maykello/Emulacja-Sony-Unilink/hardware/Sony_Unilink_Emulator.pdf

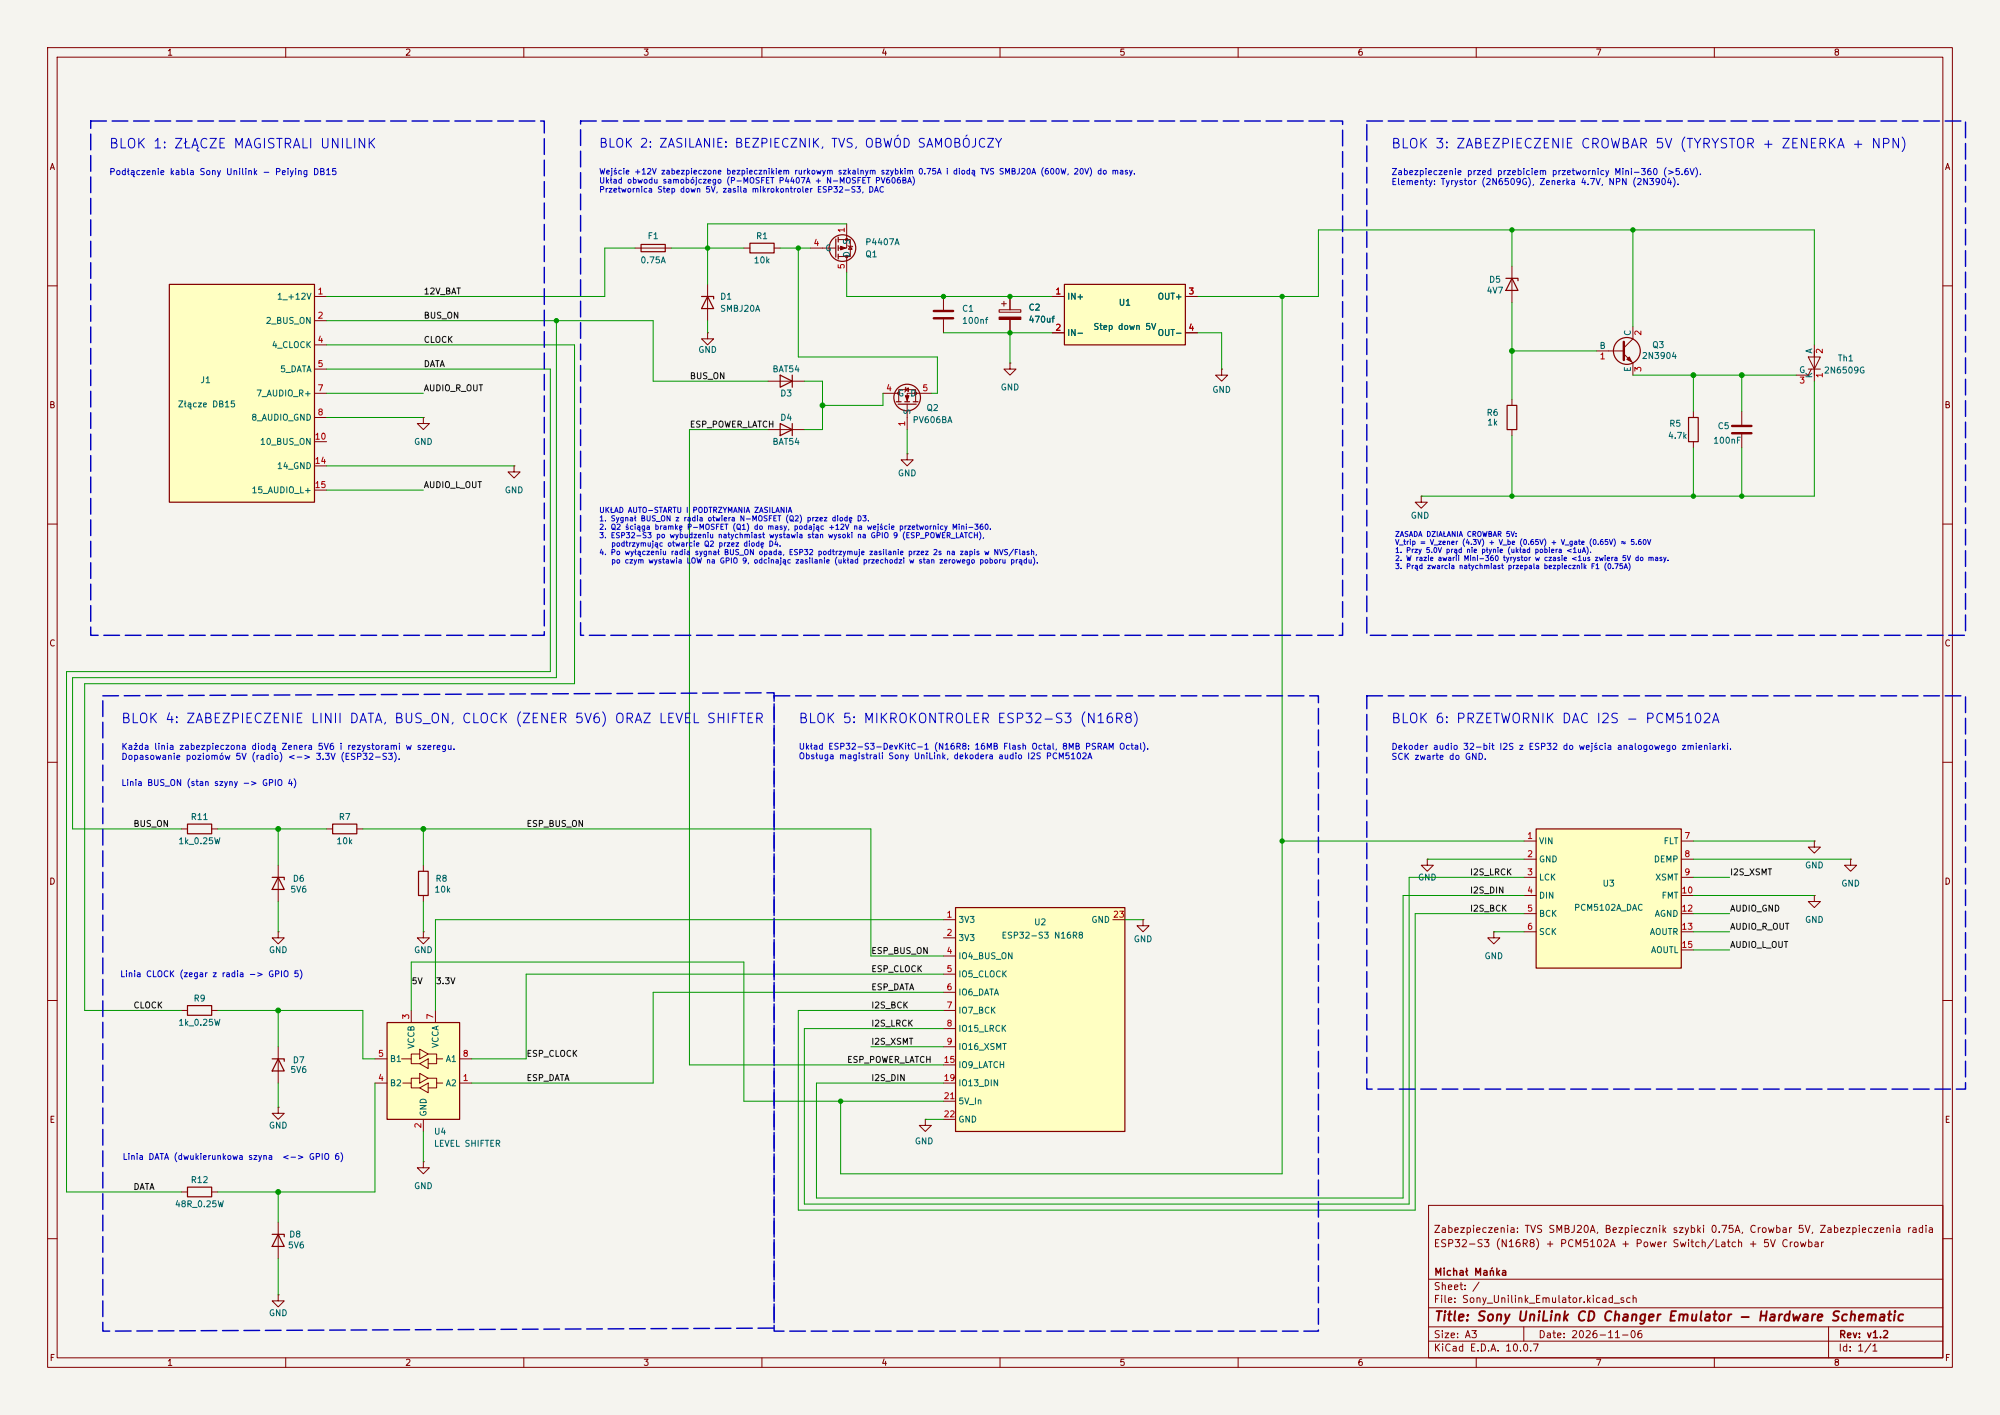
[picture p6: page 1]

Obsługa magistrali Sony UniLink, dekodera audio I2S PCM5102A BLOK 1: ZŁĄCZE MAGISTRALI UNILINK

BLOK 2: ZASILANIE: BEZPIECZNIK, TVS, OBWÓD SAMOBÓJCZY

BLOK 3: ZABEZPIECZENIE CROWBAR 5V (TYRYSTOR + ZENERKA + NPN)

Podłączenie kabla Sony Unilink - Peiying DB15

Wejście +12V zabezpieczone bezpiecznikiem rurkowym szkalnym szybkim 0.75A i diodą TVS SMBJ20A (600W, 20V) do masy. Układ obwodu samobójczego (P-MOSFET P4407A + N-MOSFET PV606BA) Przetwornica Step down 5V, zasila mikrokontroler ESP32-S3, DAC

Zabezpieczenie przed przebiciem przetwornicy Mini-360 (>5.6V).
Elementy: Tyrystor (2N6509G), Zenerka 4.7V, NPN (2N3904).

ZASADA DZIAŁANIA CROWBAR 5V: V_trip = V_zener (4.3V) + V_be (0.65V) + V_gate (0.65V) ≈ 5.60V 1. Przy 5.0V prąd nie płynie (układ pobiera <1uA). 2. W razie awarii Mini-360 tyrystor w czasie <1us zwiera 5V do masy. 3. Prąd zwarcia natychmiast przepala bezpiecznik F1 (0.75A)

BLOK 4: ZABEZPIECZENIE LINII DATA, BUS_ON, CLOCK (ZENER 5V6) ORAZ LEVEL SHIFTER
10k GND

Układ ESP32-S3-DevKitC-1 (N16R8: 16MB Flash Octal, 8MB PSRAM Octal).

Linia BUS_ON (stan szyny -> GPIO 4)

Linia CLOCK (zegar z radia -> GPIO 5)

Linia DATA (dwukierunkowa szyna <-> GPIO 6)

Zabezpieczenia: TVS SMBJ20A, Bezpiecznik szybki 0.75A, Crowbar 5V, Zabezpieczenia radia
ESP32-S3 (N16R8) + PCM5102A + Power Switch/Latch + 5V Crowbar

Michał Mańka
Sheet: /
File: Sony_Unilink_Emulator.kicad_sch
Title: Sony UniLink CD Changer Emulator - Hardware Schematic

Size: A3 | Rev: v1.2 | F Date: 2026-11-06
KiCad E.D.A. 10.0.7 | Id: 1/1
