maykello/Emulacja-Sony-Unilink/hardware/Sony_Unilink_Emulator.kicad_sch

## KiCad design hardware/Sony_Unilink_Emulator.kicad_sch (2026-11-06)

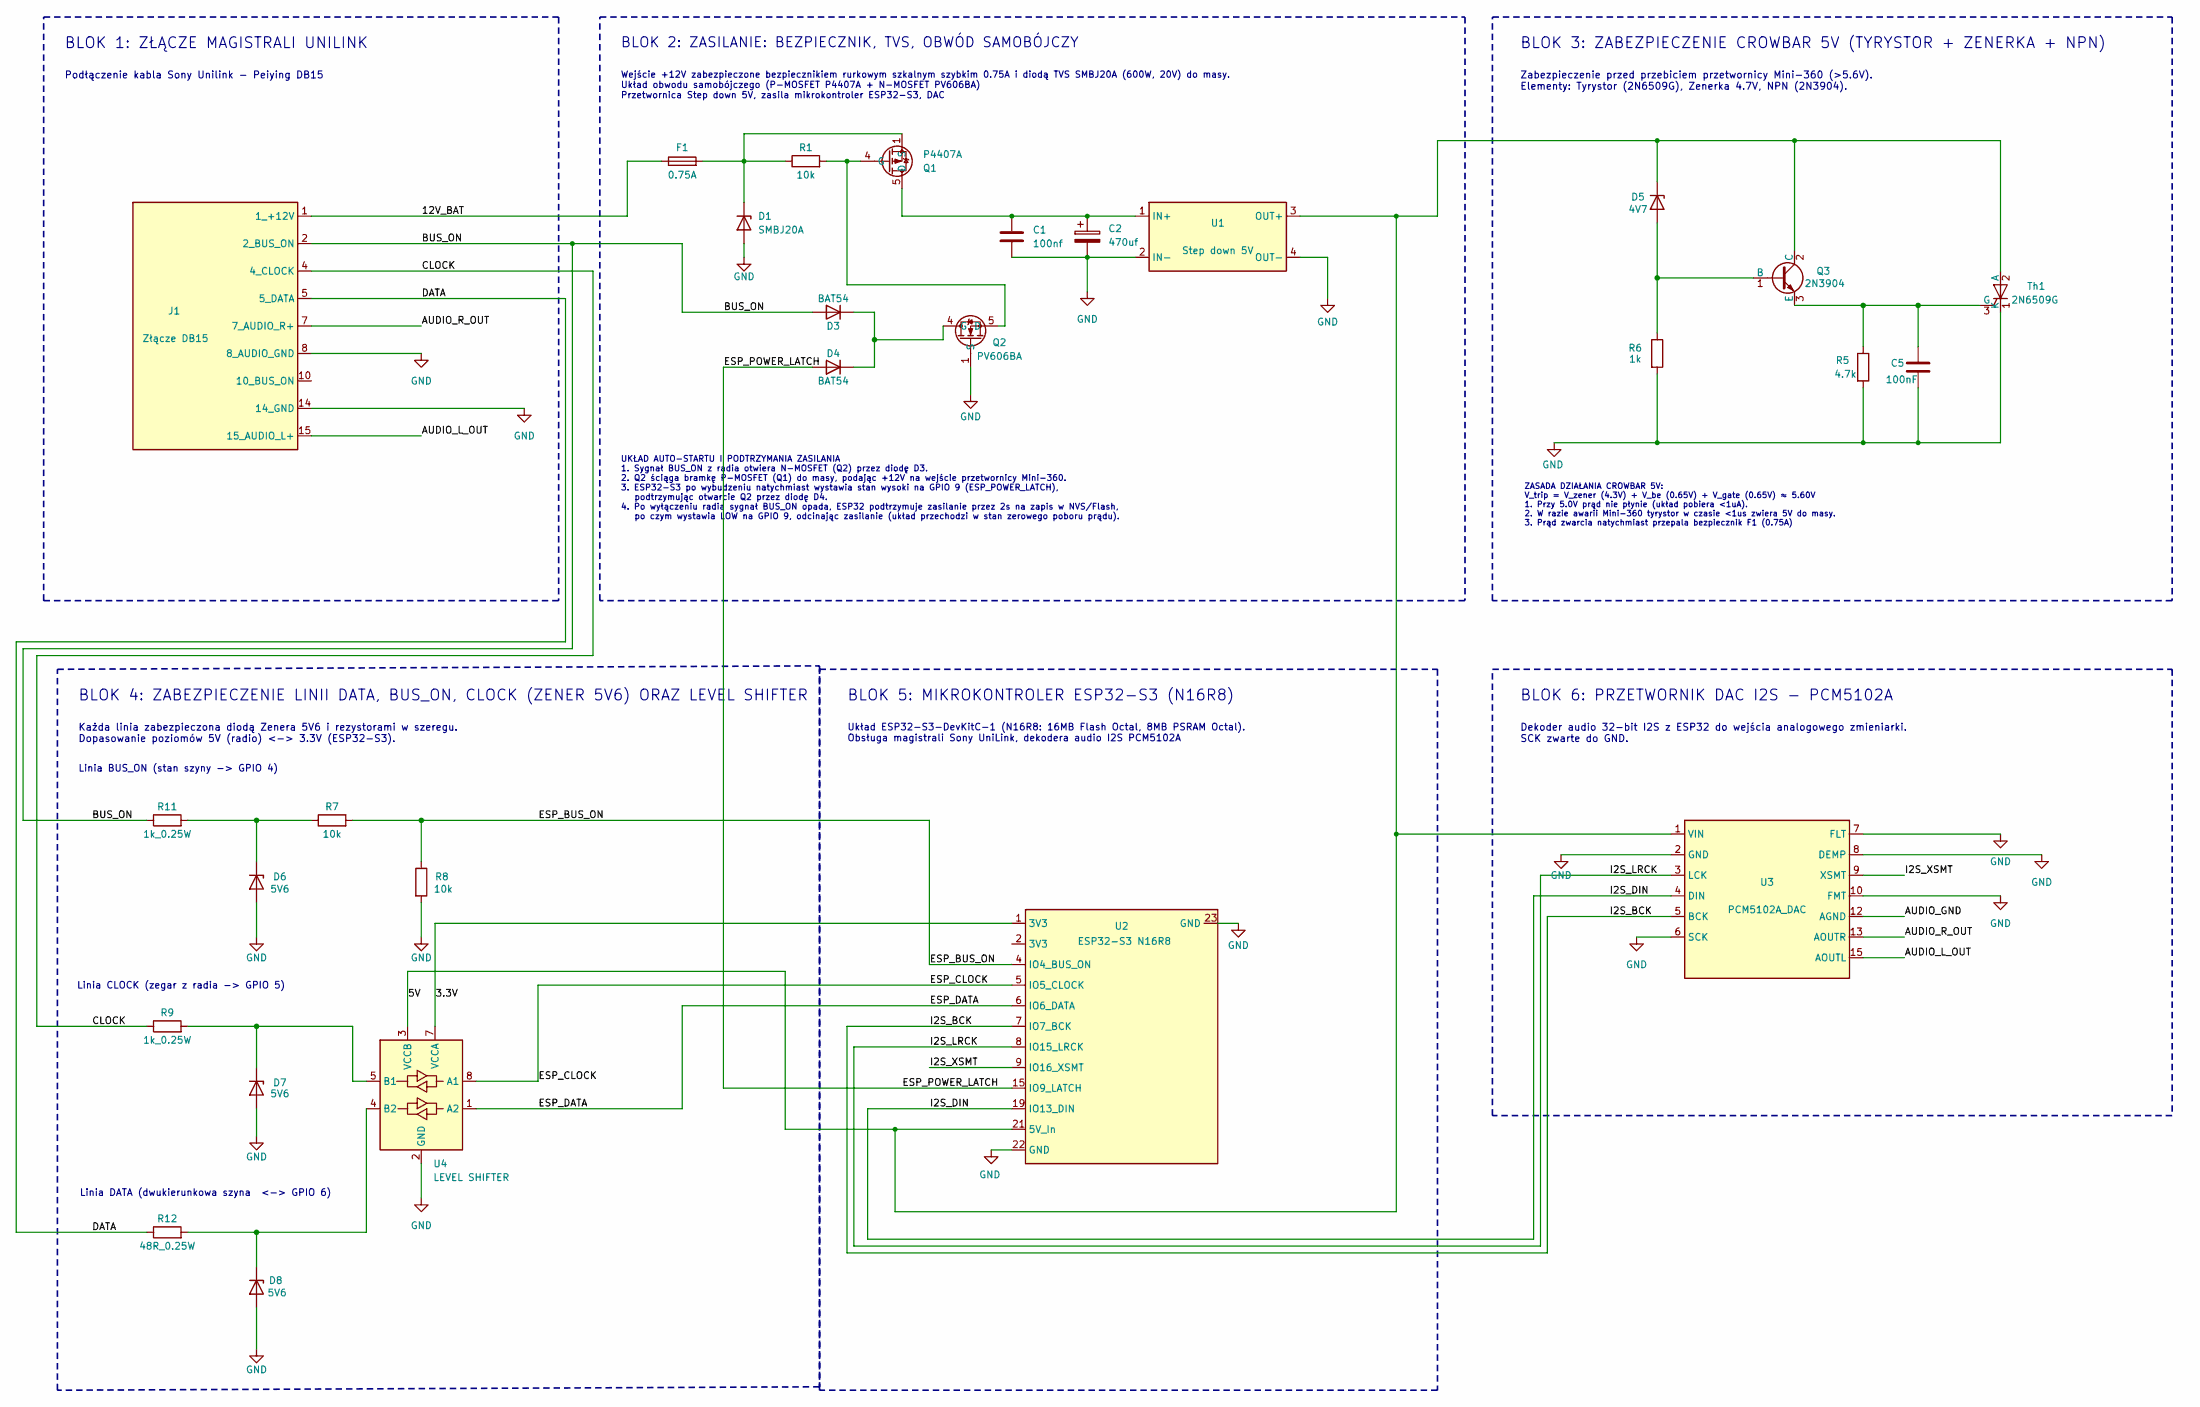
[picture p7: schematic Sony_Unilink_Emulator.kicad_sch]

Parts:
C1: 100nf
C2: 470uf
C5: 100nF; C_0805_2012Metric
D1: SMBJ20A; Nexperia_DSN1608-2_1.6x0.8mm
D3, D4: BAT54; D_SOD-323
D5: 4V7; D_DO-35_SOD27_P7.62mm_Horizontal
D6, D7, D8: 5V6; D_DO-35_SOD27_P7.62mm_Horizontal
F1: 0.75A; Fuse_0805_2012Metric
J1: Złącze DB15; DSUB-15_Female_Horizontal_P2.77x2.84mm_EdgePinOffset4.94mm
Q1: P4407A
Q2: PV606BA; SOT-223-3_TabPin2
Q3: 2N3904; TO-92_Inline
R1: 10k
R5: 4.7k; R_0805_2012Metric
R6: 1k; R_0805_2012Metric
R7, R8: 10k; R_0805_2012Metric
R9, R11: 1k_0.25W; R_0805_2012Metric
R12: 48R_0.25W; R_0805_2012Metric
Th1: 2N6509G; TO-220-3_Vertical
U1: Step down 5V; Mini-360
U2: ESP32-S3 N16R8; ESP32-S3-DevKitC-1
U3: PCM5102A_DAC; DIP-14_W7.62mm
U4: LEVEL SHIFTER; VSSOP-8_2.3x2mm_P0.5mm

Connections:
3.3V: U2.1 (3V3), U4.7 (VCCA)
5V: D5.2 (K), Q3.2 (C), Th1.2 (A), U1.3 (OUT+), U2.21 (5V_In), U3.1 (VIN), U4.3 (VCCB)
12V_BAT: F1.1, J1.1 (1_+12V)
AUDIO_GND: U3.12 (AGND)
AUDIO_L_OUT: J1.15 (15_AUDIO_L+), U3.15 (AOUTL)
AUDIO_R_OUT: J1.7 (7_AUDIO_R+), U3.13 (AOUTR)
BUS_ON: D3.2 (A), J1.2 (2_BUS_ON), R11.1
CLOCK: J1.4 (4_CLOCK), R9.1
DATA: J1.5 (5_DATA), R12.1
ESP_BUS_ON: R7.2, R8.1, U2.4 (IO4_BUS_ON)
ESP_CLOCK: U2.5 (IO5_CLOCK), U4.8 (A1)
ESP_DATA: U2.6 (IO6_DATA), U4.1 (A2)
ESP_POWER_LATCH: D4.2 (A), U2.15 (IO9_LATCH)
GND: C1.2, C2.2, C5.2, D1.2 (A), D6.2 (A), D7.2 (A), D8.2 (A), J1.8 (8_AUDIO_GND), J1.14 (14_GND), Q2.1 (S), Q2.2 (S), Q2.3 (S), R5.2, R6.2, R8.2, Th1.1 (K), U1.2 (IN-), U1.4 (OUT-), U2.22 (GND), U2.23 (GND), U3.2 (GND), U3.6 (SCK), U3.7 (FLT), U3.8 (DEMP), U3.10 (FMT), U4.2 (GND)
I2S_BCK: U2.7 (IO7_BCK), U3.5 (BCK)
I2S_DIN: U2.19 (IO13_DIN), U3.4 (DIN)
I2S_LRCK: U2.8 (IO15_LRCK), U3.3 (LCK)
I2S_XSMT: U2.9 (IO16_XSMT), U3.9 (XSMT)
unnamed: C1.1, C2.1, Q1.5 (D), Q1.6 (D), Q1.7 (D), Q1.8 (D), U1.1 (IN+)
unnamed: C5.1, Q3.3 (E), R5.1, Th1.3 (G)
unnamed: D1.1 (K), F1.2, Q1.1 (S), Q1.2 (S), Q1.3 (S), R1.1
unnamed: D3.1 (K), D4.1 (K), Q2.4 (G)
unnamed: D5.1 (A), Q3.1 (B), R6.1
unnamed: D6.1 (K), R7.1, R11.2
unnamed: D7.1 (K), R9.2, U4.5 (B1)
unnamed: D8.1 (K), R12.2, U4.4 (B2)
unnamed: Q1.4 (G), Q2.5 (D), Q2.6 (D), Q2.7 (D), Q2.8 (D), R1.2

Notes on the sheet:
Podłączenie kabla Sony Unilink - Peiying DB15
Układ ESP32-S3-DevKitC-1 (N16R8: 16MB Flash Octal, 8MB PSRAM Octal). Obsługa magistrali Sony UniLink, dekodera audio I2S PCM5102A
BLOK 1: ZŁĄCZE MAGISTRALI UNILINK
BLOK 3: ZABEZPIECZENIE CROWBAR 5V (TYRYSTOR + ZENERKA + NPN)
Linia BUS_ON (stan szyny -> GPIO 4)
Linia CLOCK (zegar z radia -> GPIO 5)
Zabezpieczenie przed przebiciem przetwornicy Mini-360 (>5.6V). Elementy: Tyrystor (2N6509G), Zenerka 4.7V, NPN (2N3904).
Linia DATA (dwukierunkowa szyna <-> GPIO 6)
Każda linia zabezpieczona diodą Zenera 5V6 i rezystorami w szeregu. Dopasowanie poziomów 5V (radio) <-> 3.3V (ESP32-S3).
Dekoder audio 32-bit I2S z ESP32 do wejścia analogowego zmieniarki. SCK zwarte do GND.
UKŁAD AUTO-STARTU I PODTRZYMANIA ZASILANIA 1. Sygnał BUS_ON z radia otwiera N-MOSFET (Q2) przez diodę D3. 2. Q2 ściąga bramkę P-MOSFET (Q1) do masy, podając +12V na wejście przetwornicy Mini-360. 3. ESP32-S3 po wybudzeniu natychmiast wystawia stan wysoki na GPIO 9 (ESP_POWER_LATCH), podtrzymując ot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
BLOK 4: ZABEZPIECZENIE LINII DATA, BUS_ON, CLOCK (ZENER 5V6) ORAZ LEVEL SHIFTER
ZASADA DZIAŁANIA CROWBAR 5V: V_trip = V_zener (4.3V) + V_be (0.65V) + V_gate (0.65V) ≈ 5.60V 1. Przy 5.0V prąd nie płynie (układ pobiera <1uA). 2. W razie awarii Mini-360 tyrystor w czasie <1us zwiera 5V do masy. 3. Prąd zwarcia natychmiast przepala bezpiecznik F1 (0.75A)
BLOK 6: PRZETWORNIK DAC I2S - PCM5102A
BLOK 5: MIKROKONTROLER ESP32-S3 (N16R8)
BLOK 2: ZASILANIE: BEZPIECZNIK, TVS, OBWÓD SAMOBÓJCZY
Wejście +12V zabezpieczone bezpiecznikiem rurkowym szkalnym szybkim 0.75A i diodą TVS SMBJ20A (600W, 20V) do masy. Układ obwodu samobójczego (P-MOSFET P4407A + N-MOSFET PV606BA) Przetwornica Step down 5V, zasila mikrokontroler ESP32-S3, DAC
