maykello/Emulacja-Sony-Unilink/ESP32/Emulator/src/AudioPlayer.cpp

#include "AudioPlayer.h"
#include "UsbDrive.h"
#include "Config.h"
#include "Diagnostics.h"
#include "UnilinkProtocol.h"
#include "Audio.h"     // ESP32-audioI2S by schreibfaul1
#include "freertos/FreeRTOS.h"
#include "freertos/task.h"
#include "freertos/semphr.h"
#include <string.h>
#include <LittleFS.h>
#include "ff.h"

// --- Obiekt audio (globalny singleton z biblioteki ESP32-audioI2S) ---
Audio audio;

// --- Stan wewnętrzny ---
// Przechowujemy posortowane nazwy plików dla każdego dysku.
// trackFiles[disc][index] = nazwa pliku (basename, np. "Metallica - Enter Sandman.mp3")
// trackCount[disc] = ile plików znaleziono na danym dysku
// Indeksy: disc 1..14, track index 0-based wewnętrznie (externally 1-based)
#define MAX_TRACKS_STORED  MAX_TRACKS   // max 99 tracków na dysk
static String trackFiles[MAX_DISCS + 1][MAX_TRACKS_STORED]; // [disc 1..14][0..98]
static uint8_t trackCount[MAX_DISCS + 1]; // indeks 1..14, [0] nieużywany

// Katalog płyty na nośniku i etykieta pokazywana w radiu.
// Konwencja nazw folderów: "CDnn" albo "CDnn.Nazwa" (np. "CD01.ABBA").
// Numer slotu zostaje w nazwie katalogu (zmieniarka wie, który folder to która
// płyta), a na ekran radia idzie wyłącznie część po kropce ("ABBA").
static String discDirName[MAX_DISCS + 1];  // np. "CD01.ABBA"
static String discLabel[MAX_DISCS + 1];    // np. "ABBA"
// Indeks czyta zadanie magistrali (rdzen 1, wysoki priorytet), a przebudowuje
// petla glowna (ten sam rdzen, niski priorytet). Flage zerujemy PRZED pierwsza
// modyfikacja tablic — czytelnik sprawdza ja na wejsciu i nie moze zostac
// wywlaszczony przez petle, wiec nigdy nie trafi na przepisywany String.
static volatile bool s_indexReady = false;
static volatile bool songFinishedFlag = false;
static volatile bool isPlaying = false;
static bool wasUsbMounted = false;   // do wykrywania hot-plug/unplug

// Flaga "trwa zmiana utworu" — chroni przed FALSZYWYM wykryciem konca utworu.
// Gdy zmieniamy track/plyte, audio.stopSong() na chwile ustawia isRunning()=false,
// a getAudioCurrentTime() zwraca jeszcze stary czas (>0). Bez tej flagi
// awaryjny detektor konca utworu odpalal AUTO-NEXT i przeskakiwal na TR2.
static volatile bool trackChanging = false;

// Flaga "utwor faktycznie ruszyl" — ustawiana gdy biblioteka zacznie dekodowac
// (audio.isRunning()==true). Kasowana przy zadaniu nowego utworu. Dzieki niej
// wykrywamy KONIEC utworu nawet gdy biblioteka zeruje getAudioCurrentTime() do 0
// (tak dzieje sie przy naturalnym EOF). Wczesniej detektor zapasowy wymagal
// getAudioCurrentTime() > 0, przez co po skonczeniu utworu (czas=0, isRunning=0)
// nigdy nie odpalal AUTO-NEXT i zegar tykal w nieskonczonosc.
static volatile bool songStarted = false;

// --- Synchronizacja audio (osobny task FreeRTOS) ---
static SemaphoreHandle_t audioMutex = NULL;
static TaskHandle_t audioTaskHandle = NULL;

// --- Żądania asynchroniczne ---
static volatile bool playRequestPending = false;
static char playRequestPath[128];
static volatile uint32_t playRequestStartSec = 0;

// Sterowanie audio z GLOWNEJ petli (Core 1) NIGDY nie moze blokowac sie na
// audioMutex — w przeciwnym razie nacisniecie klawisza czeka, az task audio
// zwolni mutex (np. po connecttoFS/decode), co zamraza odpowiedzi na radio,
// licznik czasu i gubi powtorzone komendy FF/REW. Dlatego seek/stop/volume
// przekazujemy jako ZADANIA, ktore realizuje task audio (Core 0).
static volatile bool     seekRequestPending = false;
static volatile int      seekRequestDelta   = 0;   // akumulowany skok (+/- s)
static volatile bool     seekTargetPending  = false;
static volatile uint32_t seekTargetSec      = 0;   // docelowa sekunda od poczatku utworu
static volatile bool     stopRequestPending = false;
static volatile bool     volRequestPending  = false;
static volatile uint8_t  volRequestValue    = AUDIO_VOLUME;
// Gdy true — audio_info pomija wysokoczęstotliwosciowe komunikaty dekodera.
// Ustawiane z CdChanger na czas skanowania FF/REW (patrz audioSetInfoSquelch).
static volatile bool infoSquelch = false;


// ============================================================
// Pomocnicza: czy plik ma obsługiwane rozszerzenie audio?
// ============================================================
static bool isAudioFile(const String &name) {
    int dotPos = name.lastIndexOf('.');
    if (dotPos < 1) return false;
    
    String ext = name.substring(dotPos);
    ext.toLowerCase();
    return (ext == ".mp3" || ext == ".wav" || ext == ".flac" || ext == ".aac");
}

// ============================================================
// Pomocnicza: wyciągnij basename ze ścieżki
// ESP32 VFS: File::name() zwraca pełną ścieżkę (np. "/usb/CD01/plik.mp3")
// ============================================================
static String getBasename(const String &path) {
    int lastSlash = path.lastIndexOf('/');
    return (lastSlash >= 0) ? path.substring(lastSlash + 1) : path;
}

// ============================================================
// Proste sortowanie alfabetyczne bez rozróżniania wielkości liter (case-insensitive)
// ============================================================
static void sortStrings(String arr[], int count) {
    for (int i = 1; i < count; i++) {
        String key = arr[i];
        int j = i - 1;
        while (j >= 0 && strcasecmp(arr[j].c_str(), key.c_str()) > 0) {
            arr[j + 1] = arr[j];
            j--;
        }
        arr[j + 1] = key;
    }
}

// ============================================================
// Rozpoznanie katalogu płyty: "CDnn" albo "CDnn.Nazwa"
// Zwraca numer płyty 1..MAX_DISCS, albo 0 gdy nazwa nie pasuje.
// `label` dostaje część po kropce, a gdy jej nie ma — samo "CDnn".
// ============================================================
static uint8_t parseDiscDir(const String &dirName, String &label) {
    if (dirName.length() < 4) return 0;

    const char c0 = dirName[0];
    const char c1 = dirName[1];
    if ((c0 != 'C' && c0 != 'c') || (c1 != 'D' && c1 != 'd')) return 0;
    if (dirName[2] < '0' || dirName[2] > '9') return 0;
    if (dirName[3] < '0' || dirName[3] > '9') return 0;

    const int num = (dirName[2] - '0') * 10 + (dirName[3] - '0');
    if (num < 1 || num > MAX_DISCS) return 0;

    // Sam numer, bez sufiksu — etykietą zostaje nazwa folderu.
    if (dirName.length() == 4) {
        label = dirName;
        return (uint8_t)num;
    }

    // Po numerze dopuszczamy WYŁĄCZNIE kropkę, żeby np. "CD01backup" nie
    // przechwycił slotu 1 przypadkiem.
    if (dirName[4] != '.') return 0;

    String rest = dirName.substring(5);
    rest.trim();
    label = (rest.length() > 0) ? rest : dirName.substring(0, 4);
    return (uint8_t)num;
}

// ============================================================
// Skanowanie folderów płyt na pendrivie
// Zbiera WSZYSTKIE pliki audio (dowolna nazwa), sortuje
// alfabetycznie i przypisuje numery tracków 1, 2, 3...
// ============================================================
static void performDeepScan() {
    if (!usbDriveIsMounted()) {
        Serial.println("[Audio] Pendrive nie zamontowany — nie mogę skanować.");
        return;
    }

    fs::FS &fs = usbDriveGetFS();

    // Nie zerujemy s_indexReady ani starych trackCount na starcie skanu:
    // radio w tym oknie widzialoby pusty magazynek i "NO PENDRIVE".
    String foundDir[MAX_DISCS + 1];
    String foundLabel[MAX_DISCS + 1];

    // --- Krok 1: przypisz katalogi z nośnika do slotów płyt ---
    // Katalogu nie da się już otworzyć "po numerze", bo nazwa może mieć dowolny
    // sufiks po kropce — trzeba przejrzeć katalog główny.
    File root = fs.open("/");
    if (root && root.isDirectory()) {
        File entry;
        while ((entry = root.openNextFile())) {
            if (entry.isDirectory()) {
                const String name = getBasename(String(entry.name()));
                String label;
                const uint8_t d = parseDiscDir(name, label);
                // Przy dwóch folderach na ten sam numer wygrywa pierwszy.
                if (d != 0 && foundDir[d].length() == 0) {
                    foundDir[d]   = name;
                    foundLabel[d] = label;
                }
            }
            entry.close();
        }
    }
    if (root) root.close();

    // --- Krok 2: zbierz pliki audio z każdego znalezionego katalogu ---
    for (int d = 1; d <= MAX_DISCS; d++) {
        if (foundDir[d].length() == 0) {
            trackCount[d]  = 0;
            discDirName[d] = "";
            discLabel[d]   = "";
            for (int t = 0; t < MAX_TRACKS_STORED; t++) trackFiles[d][t] = "";
            continue;
        }

        discDirName[d] = foundDir[d];
        discLabel[d]   = foundLabel[d];
        const String dirPath = String("/") + discDirName[d];

        File dir = fs.open(dirPath.c_str());
        if (!dir || !dir.isDirectory()) {
            if (dir) dir.close();
            trackCount[d] = 0;
            continue;
        }
        
        // Zbierz wszystkie pliki audio z folderu
        int count = 0;
        File entry;
        while ((entry = dir.openNextFile()) && count < MAX_TRACKS_STORED) {
            if (entry.isDirectory()) {
                entry.close();
                continue;
            }
            
            String fullPath = entry.name();
            entry.close();
            
            String name = getBasename(fullPath);
            
            if (isAudioFile(name)) {
                trackFiles[d][count] = name;
                count++;
            }
        }
        dir.close();
        
        if (count == 0) {
            trackCount[d] = 0;
            continue;
        }

        // Sortuj alfabetycznie — kolejność plików = numery tracków
        sortStrings(trackFiles[d], count);
        trackCount[d] = count;
        s_indexReady = true;
        
        Serial.printf("[Audio] CD%02d [%s] nazwa=\"%s\": %d track(ów)\n",
                      d, discDirName[d].c_str(), discLabel[d].c_str(), count);
    }
    s_indexReady = true;
}

// ============================================================
// Zapisywanie i odczytywanie indeksu z/do pliku
// Format tekstowy:
// Wersja|Darmowe_Klastry
// Dysk|Katalog|Etykieta|LiczbaTrackow
// Dysk|NazwaPliku (powtarzane 'LiczbaTrackow' razy)
// ============================================================
static bool saveIndexToFile() {
    if (!usbDriveIsMounted()) return false;
    
    // Pobierz wolne klastry z FatFs (z dysku "1:")
    DWORD fre_clust = 0;
    FATFS *fs_ptr;
    if (f_getfree("1:", &fre_clust, &fs_ptr) != FR_OK) {
        Serial.println("[Audio] Błąd pobierania wolnych klastrów.");
    }
    
    Diagnostics::recordNote("FLASH");
    File file = LittleFS.open(INDEX_FILE_PATH, FILE_WRITE);
    if (!file) {
        Diagnostics::recordNote("FLEND");
        Serial.println("[Audio] Błąd otwarcia pliku indeksu do zapisu w LittleFS.");
        return false;
    }
    
    file.printf("UNILINK_INDEX_V3|%lu\n", (unsigned long)fre_clust);
    for (int d = 1; d <= MAX_DISCS; d++) {
        if (trackCount[d] == 0) continue;
        
        // Zapisz nagłówek dysku
        file.printf("%d|%s|%s|%d\n", d, discDirName[d].c_str(), discLabel[d].c_str(), trackCount[d]);
        
        // Zapisz ścieżki plików
        for (int t = 0; t < trackCount[d]; t++) {
            file.printf("%d|%s\n", d, trackFiles[d][t].c_str());
        }
    }
    file.close();
    Diagnostics::recordNote("FLEND");
    Serial.printf("[Audio] Zapisano indeks do pliku (free_clusters=%lu).\n", (unsigned long)fre_clust);
    return true;
}

static bool loadIndexFromFile() {
    if (!usbDriveIsMounted()) return false;
    
    if (!LittleFS.exists(INDEX_FILE_PATH)) {
        return false; // Brak pliku indeksu
    }
    
    // Pobierz wolne klastry z FatFs (z dysku "1:")
    DWORD fre_clust = 0;
    FATFS *fs_ptr;
    if (f_getfree("1:", &fre_clust, &fs_ptr) != FR_OK) {
        Serial.println("[Audio] Błąd pobierania wolnych klastrów dla sprawdzenia.");
    }
    unsigned long current_free_clusters = (unsigned long)fre_clust;
    
    File file = LittleFS.open(INDEX_FILE_PATH, FILE_READ);
    if (!file) {
        Serial.println("[Audio] Błąd otwarcia pliku indeksu do odczytu w LittleFS.");
        return false;
    }
    
    String header = file.readStringUntil('\n');
    header.trim();
    int pipeIdx = header.indexOf('|');
    if (pipeIdx < 0 || header.substring(0, pipeIdx) != "UNILINK_INDEX_V3") {
        Serial.println("[Audio] Zła wersja pliku indeksu lub uszkodzony nagłówek.");
        file.close();
        return false;
    }
    
    unsigned long saved_free_clusters = strtoul(header.substring(pipeIdx + 1).c_str(), NULL, 10);
    
    if (saved_free_clusters != current_free_clusters) {
        Serial.printf("[Audio] Zmiana na pendrive! Oczekiwano %lu wolnych klastrów, jest %lu.\n", 
                      saved_free_clusters, current_free_clusters);
        file.close();
        return false;
    }
    
    // Wyczyść stare wpisy
    s_indexReady = false;
    for (int d = 1; d <= MAX_DISCS; d++) {
        trackCount[d]  = 0;
        discDirName[d] = "";
        discLabel[d]   = "";
        for (int t = 0; t < MAX_TRACKS_STORED; t++) {
            trackFiles[d][t] = "";
        }
    }
    
    int currentDisc = 0;
    int expectedTracks = 0;
    int loadedTracks = 0;
    
    while (file.available()) {
        String line = file.readStringUntil('\n');
        line.trim();
        if (line.length() == 0) continue;
        
        int firstPipe = line.indexOf('|');
        if (firstPipe < 0) continue;
        
        int disc = line.substring(0, firstPipe).toInt();
        if (disc < 1 || disc > MAX_DISCS) continue;
        
        int secondPipe = line.indexOf('|', firstPipe + 1);
        
        if (secondPipe > 0) {
            // Nagłówek dysku: Dysk|Katalog|Etykieta|LiczbaTrackow
            int thirdPipe = line.indexOf('|', secondPipe + 1);
            if (thirdPipe > 0) {
                currentDisc = disc;
                discDirName[currentDisc] = line.substring(firstPipe + 1, secondPipe);
                discLabel[currentDisc] = line.substring(secondPipe + 1, thirdPipe);
                expectedTracks = line.substring(thirdPipe + 1).toInt();
                loadedTracks = 0;
            }
        } else {
            // Ścieżka pliku: Dysk|NazwaPliku
            if (disc == currentDisc && loadedTracks < expectedTracks && loadedTracks < MAX_TRACKS_STORED) {
                trackFiles[currentDisc][loadedTracks] = line.substring(firstPipe + 1);
                loadedTracks++;
                trackCount[currentDisc] = loadedTracks;
            }
        }
    }
    
    file.close();
    s_indexReady = true;
    Serial.println("[Audio] Pomyślnie wczytano indeks z wbudowanej pamięci.");
    
    // Wypisz dla debugowania
    for (int d = 1; d <= MAX_DISCS; d++) {
        if (trackCount[d] > 0) {
            Serial.printf("[Audio-Index] CD%02d [%s] nazwa=\"%s\": %d track(ów)\n",
                          d, discDirName[d].c_str(), discLabel[d].c_str(), trackCount[d]);
        }
    }
    return true;
}

// Zapis indeksu to zapis flash (LittleFS) — odkladamy go do okna, w ktorym
// nie zaklocimy rozmowy z radiem (zwykle tuz po starcie trwa wtedy discovery).
static volatile bool s_indexSavePending = false;

void audioRefreshIndexFreeClusters() {
    if (s_indexReady) {
        s_indexSavePending = true;
    }
}

bool audioIsBusyChangingTrack() {
    return playRequestPending || trackChanging;
}

static void scanDiscs() {
    if (!loadIndexFromFile()) {
        Serial.println("[Audio] Indeks nieaktualny lub brak. Wykonuję głębokie skanowanie...");
        performDeepScan();
        s_indexSavePending = true;
    }
}

// ============================================================
// Szukanie pliku: mapuje (disc, track) na ścieżkę
// track jest 1-based (jak na radiu)
// ============================================================
static bool findTrackPath(uint8_t disc, uint8_t track, char* outPath, size_t pathLen) {
    if (!usbDriveIsMounted() || !s_indexReady) return false;
    if (disc < 1 || disc > MAX_DISCS) return false;
    if (track < 1 || track > trackCount[disc]) return false;
    
    // track jest 1-based, tablica jest 0-based
    const String &filename = trackFiles[disc][track - 1];
    if (filename.length() == 0) return false;
    if (discDirName[disc].length() == 0) return false;

    snprintf(outPath, pathLen, "/%s/%s", discDirName[disc].c_str(), filename.c_str());
    return true;
}

static volatile bool s_seekMuted = false;

void audioSetMute(bool mute) {
    digitalWrite(I2S_XSMT_PIN, mute ? LOW : HIGH);
}

void audioSetSeekMute(bool mute) {
    s_seekMuted = mute;
    audioSetMute(mute);
}

// ============================================================
// Task dekodowania audio (FreeRTOS)
// ============================================================
// Docelowa sekunda wznowienia, dopoki dekoder do niej nie doskoczy. Do tego czasu
// dekoder gra (wyciszony) od poczatku pliku i jego czas nie moze trafic na ekran
// ani do NVS (nadpisalby zapamietana pozycje).
static volatile uint32_t s_resumeTargetSec = 0;

static void audioTaskFunc(void *param) {
    Serial.printf("[Audio] Task dekodowania uruchomiony na rdzeniu %d\n", xPortGetCoreID());
    uint32_t loopCounter = 0;
    unsigned long lastDebugTime = 0;
    unsigned long playStartedMs = 0;
    bool dacUnmuted = false;
    uint32_t pendingResumeSec = 0;
    unsigned long resumeIssuedMs = 0;
    constexpr unsigned long RESUME_GIVE_UP_MS = 5000;
    
    for (;;) {
        // --- Obsługa żądania nowej piosenki (ma pierwszenstwo przed zaleglym stop/seek) ---
        if (playRequestPending) {
            playRequestPending = false;
            stopRequestPending = false;
            seekRequestPending = false;
            seekRequestDelta   = 0;
            seekTargetPending  = false;
            pendingResumeSec   = playRequestStartSec;
            playRequestStartSec = 0;
            audioSetMute(true);
            dacUnmuted = false;
            playStartedMs = 0;
            
            if (audioMutex) xSemaphoreTake(audioMutex, portMAX_DELAY);
            audio.stopSong();
            bool result = audio.connecttoFS(usbDriveGetFS(), playRequestPath);
            if (audioMutex) xSemaphoreGive(audioMutex);
            
            Serial.printf("[Audio] Async connecttoFS(\"%s\") = %s\n", playRequestPath, result ? "OK" : "FAIL");
            
            if (!result) {
                isPlaying = false;
                songStarted = false;
                pendingResumeSec = 0;
                s_resumeTargetSec = 0;
                songFinishedFlag = true; // Pomiń do następnego utworu
                Diagnostics::setError(Diagnostics::SystemError::FileErr);
            } else {
                isPlaying = true;
                if (Diagnostics::getError() == Diagnostics::SystemError::FileErr) {
                    Diagnostics::clearError(Diagnostics::SystemError::FileErr);
                }
                Serial.printf("[Audio] ▶ Odtwarzam: %s (rozpoczęto dekodowanie)\n", playRequestPath);
            }
            // Zmiana utworu zakonczona — mozna znow wykrywac koniec utworu.
            trackChanging = false;
        }

        // --- Żądania sterujace z Core 1 (nieblokujace dla glownej petli) ---
        if (stopRequestPending) {
            stopRequestPending = false;
            seekRequestPending = false;
            seekRequestDelta   = 0;
            seekTargetPending  = false;
            audioSetMute(true);
            dacUnmuted = false;
            playStartedMs = 0;
            if (audioMutex) xSemaphoreTake(audioMutex, portMAX_DELAY);
            audio.stopSong();
            if (audioMutex) xSemaphoreGive(audioMutex);
            isPlaying = false;
            songStarted = false;
            pendingResumeSec = 0;
            s_resumeTargetSec = 0;
        }
        if (volRequestPending) {
            volRequestPending = false;
            uint8_t v = volRequestValue;
            if (audioMutex) xSemaphoreTake(audioMutex, portMAX_DELAY);
            audio.setVolume(v);
            if (audioMutex) xSemaphoreGive(audioMutex);
        }
        if (seekTargetPending) {
            seekTargetPending = false;
            seekRequestPending = false;
            seekRequestDelta = 0;
            uint32_t target = seekTargetSec;
            if (audio.isRunning()) {
                if (audioMutex) xSemaphoreTake(audioMutex, portMAX_DELAY);
                uint32_t dur = audio.getAudioFileDuration();
                if (dur > 1 && target >= dur) target = dur - 1;
                int cur = (int)audio.getAudioCurrentTime();
                int d   = (int)target - cur;
                if (d != 0) {
                    audio.setTimeOffset(d);
                }
                if (audioMutex) xSemaphoreGive(audioMutex);
            }
        } else if (seekRequestPending) {
            seekRequestPending = false;
            int d = seekRequestDelta;
            seekRequestDelta = 0;
            if (d != 0 && audio.isRunning()) {
                if (audioMutex) xSemaphoreTake(audioMutex, portMAX_DELAY);
                audio.setTimeOffset(d);
                if (audioMutex) xSemaphoreGive(audioMutex);
            }
        }

        if (audioMutex && xSemaphoreTake(audioMutex, pdMS_TO_TICKS(5)) == pdTRUE) {
            audio.loop();
            
            // Diagnostyka co 1 sekundę
            if (isPlaying && millis() - lastDebugTime > 1000) {
                if (DEBUG_VERBOSE) {
                    uint32_t size = audio.getFileSize();
                    uint32_t time = audio.getAudioCurrentTime();
                    bool running = audio.isRunning();
                    Serial.printf("[Audio-Diag] FileSize: %lu bytes | Czas: %lu s | isRunning: %d\n", 
                                  (unsigned long)size, (unsigned long)time, running);
                }
                lastDebugTime = millis();
            }
            
            xSemaphoreGive(audioMutex);
        }

        // --- Sterowanie wyciszeniem sprzętowym DAC (XSMT na GPIO 16) ---
        // Odciszamy dopiero po 100ms stabilnego działania dekodera (audio.isRunning()),
        // gdy bufor I2S DMA jest już stabilnie wypełniony próbkami i zegary są zsynchronizowane.
        if (isPlaying && audio.isRunning()) {
            songStarted = true;
            if (playStartedMs == 0) {
                playStartedMs = millis();
            }
            // Skok do zapamietanej sekundy jest mozliwy dopiero, gdy biblioteka zna
            // bitrate (po naglowku i pierwszych ramkach; duze tagi ID3 z okladka
            // czytaja sie z pendrive'a dluzej). Wczesniej setTimeOffset() po cichu
            // nic nie robi i utwor gra od poczatku. Skok bezwzgledny: wzgledny liczy
            // od pozycji odczytu pliku, ktora przez bufor wyprzedza odtwarzanie.
            if (pendingResumeSec > 0) {
                if (audioMutex) xSemaphoreTake(audioMutex, portMAX_DELAY);
                const uint32_t dur = audio.getAudioFileDuration();
                if (dur > 0) {
                    if (dur > 2 && pendingResumeSec >= dur - 1) {
                        Serial.printf("[Audio] Zapamietana pozycja %lu s poza utworem (%lu s) — gram od poczatku\n",
                                      (unsigned long)pendingResumeSec, (unsigned long)dur);
                        pendingResumeSec  = 0;
                        s_resumeTargetSec = 0;
                    } else if (audio.setAudioPlayPosition((uint16_t)pendingResumeSec)) {
                        Serial.printf("[Audio] Wznowiono pozycję odtwarzania od: %lu s (po %lu ms)\n",
                                      (unsigned long)pendingResumeSec, millis() - playStartedMs);
                        pendingResumeSec = 0;
                        resumeIssuedMs   = millis();
                        playStartedMs    = millis();   // odcisz ~100 ms po skoku
                    }
                } else if (millis() - playStartedMs > RESUME_GIVE_UP_MS) {
                    Serial.printf("[Audio] Nie udalo sie wznowic od %lu s (brak bitrate) — gram od poczatku\n",
                                  (unsigned long)pendingResumeSec);
                    pendingResumeSec  = 0;
                    s_resumeTargetSec = 0;
                }
                if (audioMutex) xSemaphoreGive(audioMutex);
            } else if (s_resumeTargetSec != 0) {
                // Skok wykonuje sie w kolejnym audio.loop(); dopiero potem czas dekodera
                // jest wiarygodny.
                if (audio.getAudioCurrentTime() + 2 >= s_resumeTargetSec ||
                    millis() - resumeIssuedMs > 2000) {
                    s_resumeTargetSec = 0;
                }
            }
            if (!s_seekMuted && !dacUnmuted && pendingResumeSec == 0 && (millis() - playStartedMs >= 100)) {
                audioSetMute(false);
                dacUnmuted = true;
                Serial.println("[Audio] DAC XSMT (GPIO 16) -> HIGH (Odciszono)");
            } else if (s_seekMuted && dacUnmuted) {
                audioSetMute(true);
                dacUnmuted = false;
            }
        } else {
            if (dacUnmuted) {
                audioSetMute(true);
                dacUnmuted = false;
                Serial.println("[Audio] DAC XSMT (GPIO 16) -> LOW (Wyciszono)");
            }
            playStartedMs = 0;
        }
        
        loopCounter++;

        if (isPlaying) {
            // Kiedy gra, oddaj czas procesora innym taskom o tym samym priorytecie
            // ale nie opóźniaj na sztywno o 1ms, bo dekoder może potrzebować
            // więcej cykli do napełnienia bufora.
            vTaskDelay(1); // Zostawiamy 1ms na USB task
        } else {
            vTaskDelay(10); // Gdy nie gra, oszczędzaj CPU
        }
    }
}

// ============================================================
// Publiczne API
// ============================================================

bool audioInit() {
    Serial.println("[Audio] Inicjalizacja...");
    
    // Zeruj tablicę tracków
    for (int i = 0; i <= MAX_DISCS; i++) trackCount[i] = 0;
    
    // 0. Konfiguracja pinu wyciszenia sprzętowego DAC (XSMT na GPIO 16) — wycisz na starcie
    pinMode(I2S_XSMT_PIN, OUTPUT);
    audioSetMute(true);
    
    // 1. Sprawdzenie zwarcia linii I2S do 3.3V (VCC) przed konfiguracją I2S
    pinMode(I2S_BCK_PIN, INPUT_PULLDOWN);
    pinMode(I2S_LRCK_PIN, INPUT_PULLDOWN);
    pinMode(I2S_DIN_PIN, INPUT_PULLDOWN);
    delay(2);
    if (digitalRead(I2S_BCK_PIN) == HIGH) {
        Serial.printf("[Audio] BŁĄD: Pin BCK (GPIO %d) zwarty do 3.3V!\n", I2S_BCK_PIN);
        Diagnostics::setError(Diagnostics::SystemError::DacPinShort, I2S_BCK_PIN);
    } else if (digitalRead(I2S_LRCK_PIN) == HIGH) {
        Serial.printf("[Audio] BŁĄD: Pin LRCK (GPIO %d) zwarty do 3.3V!\n", I2S_LRCK_PIN);
        Diagnostics::setError(Diagnostics::SystemError::DacPinShort, I2S_LRCK_PIN);
    } else if (digitalRead(I2S_DIN_PIN) == HIGH) {
        Serial.printf("[Audio] BŁĄD: Pin DIN (GPIO %d) zwarty do 3.3V!\n", I2S_DIN_PIN);
        Diagnostics::setError(Diagnostics::SystemError::DacPinShort, I2S_DIN_PIN);
    }

    // 2. Inicjalizacja USB Host (pendrive)
    if (!usbDriveInit()) {
        Serial.println("[Audio] BŁĄD: USB Host nie uruchomiony!");
        Diagnostics::setError(Diagnostics::SystemError::UsbHostErr);
    }
    
    // 3. Konfiguracja I2S → PCM5102A
    bool pinoutOk = audio.setPinout(I2S_BCK_PIN, I2S_LRCK_PIN, I2S_DIN_PIN);
    Serial.printf("[Audio] setPinout(BCK=%d, LRCK=%d, DIN=%d) = %s\n", 
                  I2S_BCK_PIN, I2S_LRCK_PIN, I2S_DIN_PIN, pinoutOk ? "OK" : "FAIL");
    if (!pinoutOk) {
        Diagnostics::setError(Diagnostics::SystemError::DacInitErr);
    }
    audio.setVolume(AUDIO_VOLUME);
    
    // Mutex do synchronizacji dostępu do obiektu audio między taskami
    audioMutex = xSemaphoreCreateMutex();
    if (!audioMutex) {
        Serial.println("[Audio] BŁĄD: Nie mogę utworzyć mutexu audio!");
        Diagnostics::setError(Diagnostics::SystemError::AudioTaskErr);
        return false;
    }
    
    // Task dekodowania audio — Core 0 (razem z USB Host), priorytet 2.
    // KLUCZOWE: trzymamy dekoder z DALA od Core 1, na ktorym dziala petla
    // Arduino + przerwanie zegara magistrali Unilink.
    BaseType_t ret = xTaskCreatePinnedToCore(
        audioTaskFunc, "audio_dec", 8192, NULL, 2, &audioTaskHandle, 0);
    if (ret != pdPASS) {
        Serial.println("[Audio] BŁĄD: Nie mogę uruchomić tasku audio!");
        Diagnostics::setError(Diagnostics::SystemError::AudioTaskErr);
        return false;
    }
    
    // Jeśli pendrive jest już zamontowany — skanuj foldery
    if (usbDriveIsMounted()) {
        wasUsbMounted = true;
        scanDiscs();
        if (audioGetTotalTrackCount() == 0) {
            Diagnostics::setError(Diagnostics::SystemError::NoTracks);
        } else {
            Diagnostics::clearError(Diagnostics::SystemError::NoTracks);
        }
        Serial.println("[Audio] Inicjalizacja zakończona — pendrive gotowy.");
    } else {
        // Nie zglaszamy bledu NoUsb od razu przy 0 ms uptime - audioLoop zglosi go dopiero
        // po uplywie pelnego czasu rozbiegowego USB_ERROR_GRACE_MS, jesli pendrive sie nie zglosi.
        Serial.println("[Audio] Inicjalizacja I2S zakończona — oczekuję na pendrive.");
    }
    
    return true;
}

bool audioPlayTrack(uint8_t disc, uint8_t track, uint32_t startSec) {
    if (!usbDriveIsMounted()) {
        Serial.println("[Audio] Pendrive nie zamontowany — nie mogę odtwarzać.");
        if (!usbDriveIsConnected()) {
            Diagnostics::setError(Diagnostics::SystemError::NoUsb);
        } else {
            Diagnostics::setError(Diagnostics::SystemError::UsbFsErr);
        }
        return false;
    }
    
    if (disc < 1 || disc > MAX_DISCS || track < 1 || track > MAX_TRACKS) {
        Serial.printf("[Audio] Nieprawidłowy disc=%d track=%d\n", disc, track);
        return false;
    }

    // Indeks w trakcie budowy — odtwarzanie wznowi CdChanger::serviceMediaMount.
    if (!s_indexReady) return false;
    
    if (trackCount[disc] == 0) {
        Serial.printf("[Audio] Pusty dysk CD%02d\n", disc);
        Diagnostics::setError(Diagnostics::SystemError::EmptyDisc);
        isPlaying = false;
        return false;
    }
    
    char path[128];  // dłuższy bufor na dowolne nazwy plików
    if (!findTrackPath(disc, track, path, sizeof(path))) {
        Serial.printf("[Audio] Brak pliku: CD%02d track %d (maks=%d)\n", disc, track, trackCount[disc]);
        Diagnostics::setError(Diagnostics::SystemError::FileErr);
        isPlaying = false;
        return false;
    }
    
    // Jeśli wcześniej wisiał błąd pustej płyty lub pliku, czyścimy go
    if (Diagnostics::getError() == Diagnostics::SystemError::EmptyDisc ||
        Diagnostics::getError() == Diagnostics::SystemError::FileErr) {
        Diagnostics::clearError(Diagnostics::getError());
    }
    
    // Zapisz ścieżkę do zmiennej globalnej i podnieś flagę dla taska asynchronicznego
    audioSetMute(true);       // Wycisz sprzętowo DAC na czas zmiany/ładowania utworu
    strlcpy(playRequestPath, path, sizeof(playRequestPath));
    playRequestStartSec = startSec;
    s_resumeTargetSec = startSec;
    songFinishedFlag = false;
    stopRequestPending = false;
    seekRequestPending = false;
    seekRequestDelta = 0;
    seekTargetPending = false;
    trackChanging = true;     // blokuj awaryjny detektor konca utworu
    songStarted = false;      // nowy utwor jeszcze nie ruszyl
    playRequestPending = true;
    
    return true; // Sukces logistyczny (fizyczne otwarcie w tle)
}

void audioStop() {
    // Nieblokujaco: zlec zatrzymanie taskowi audio. isPlaying gasimy od razu,
    // by reszta systemu natychmiast widziala "nie gram".
    audioSetMute(true);       // Wycisz sprzętowo DAC natychmiast
    isPlaying = false;
    playRequestPending = false;
    trackChanging = false;
    stopRequestPending = true;
    Serial.println("[Audio] ⏹ Zatrzymano (zlecone).");
}

bool audioIsPlaying() {
    return isPlaying && audio.isRunning();
}

uint32_t audioGetCurrentTimeSec() {
    if (!audioIsPlaying()) return 0;
    const uint32_t target = s_resumeTargetSec;
    if (target != 0) return target;
    return audio.getAudioCurrentTime();
}

uint32_t audioGetDurationSec() {
    return audio.getAudioFileDuration();
}

bool audioSeekRelative(int deltaSec) {
    if (!audioIsPlaying()) return false;
    seekRequestDelta += deltaSec;
    seekRequestPending = true;
    return true;
}

bool audioSeekToSec(uint32_t targetSec) {
    if (!audioIsPlaying()) return false;
    seekTargetSec = targetSec;
    seekTargetPending = true;
    return true;
}

void audioSetInfoSquelch(bool squelch) {
    infoSquelch = squelch;
}

uint8_t audioGetTrackCount(uint8_t disc) {
    if (!s_indexReady || disc < 1 || disc > MAX_DISCS) return 0;
    return trackCount[disc];
}

bool audioIndexReady() {
    return s_indexReady;
}

uint16_t audioGetTotalTrackCount() {
    if (!s_indexReady) return 0;
    uint16_t total = 0;
    for (int i = 1; i <= MAX_DISCS; i++) {
        total += trackCount[i];
    }
    return total;
}

// ============================================================
// Interfejs nazw (źródło dla modułu CD-TEXT)
// ============================================================

static size_t copyBounded(const char* src, char* out, size_t maxLen) {
    if (!out || maxLen == 0) return 0;
    size_t n = 0;
    if (src) {
        while (src[n] != '\0' && n < maxLen - 1) {
            out[n] = src[n];
            n++;
        }
    }
    out[n] = '\0';
    return n;
}

size_t audioGetTrackName(uint8_t disc, uint8_t track, char* out, size_t maxLen) {
    if (out && maxLen > 0) out[0] = '\0';
    if (!s_indexReady || disc < 1 || disc > MAX_DISCS) return 0;
    if (track < 1 || track > trackCount[disc]) return 0;

    const String &filename = trackFiles[disc][track - 1];
    if (filename.length() == 0) return 0;

    // Bez String::substring — wolane z rdzenia magistrali (patrz WiFiLoggerClass::printf).
    const int dotPos = filename.lastIndexOf('.');
    const size_t copied = copyBounded(filename.c_str(), out, maxLen);
    if (dotPos > 0 && (size_t)dotPos < copied) {
        out[dotPos] = '\0';
        return (size_t)dotPos;
    }
    return copied;
}

size_t audioGetDiscName(uint8_t disc, char* out, size_t maxLen) {
    if (out && maxLen > 0) out[0] = '\0';
    if (disc < 1 || disc > MAX_DISCS) return 0;

    if (s_indexReady && discLabel[disc].length() > 0) {
        return copyBounded(discLabel[disc].c_str(), out, maxLen);
    }

    char fallback[8];
    snprintf(fallback, sizeof(fallback), "CD%02d", disc);
    return copyBounded(fallback, out, maxLen);
}

uint8_t audioFindNextNonEmptyDisc(uint8_t disc) {
    if (!s_indexReady) return 0;
    for (int i = 1; i <= MAX_DISCS; i++) {
        uint8_t candidate = ((disc - 1 + i) % MAX_DISCS) + 1;
        if (trackCount[candidate] > 0) return candidate;
    }
    return 0;
}

uint8_t audioFindPrevNonEmptyDisc(uint8_t disc) {
    if (!s_indexReady) return 0;
    for (int i = 1; i <= MAX_DISCS; i++) {
        uint8_t candidate = ((disc - 1 - i + MAX_DISCS) % MAX_DISCS) + 1;
        if (trackCount[candidate] > 0) return candidate;
    }
    return 0;
}

bool audioSongFinished() {
    if (songFinishedFlag) {
        songFinishedFlag = false;
        return true;
    }
    return false;
}

void audioLoop() {
    // --- Hot-plug/unplug pendrive'a ---
    bool isMounted = usbDriveIsMounted();
    
    if (isMounted && !wasUsbMounted) {
        // Pendrive właśnie podpięty → skanuj foldery
        Serial.println("[Audio] Pendrive podpięty — skanowanie folderów...");
        scanDiscs();
        if (audioGetTotalTrackCount() == 0) {
            Diagnostics::setError(Diagnostics::SystemError::NoTracks);
        } else {
            if (Diagnostics::getError() == Diagnostics::SystemError::NoUsb ||
                Diagnostics::getError() == Diagnostics::SystemError::UsbFsErr ||
                Diagnostics::getError() == Diagnostics::SystemError::NoTracks ||
                Diagnostics::getError() == Diagnostics::SystemError::EmptyDisc ||
                Diagnostics::getError() == Diagnostics::SystemError::FileErr) {
                Diagnostics::clearError(Diagnostics::getError());
            }
        }
    }
    else if (!isMounted && wasUsbMounted) {
        // Pendrive odłączony → zatrzymaj audio, wyczyść tracki
        Serial.println("[Audio] Pendrive odłączony — zatrzymuję odtwarzanie.");
        audioSetMute(true);
        stopRequestPending = true;   // nieblokujaco (task audio wykona stopSong)
        isPlaying = false;
        songFinishedFlag = false;
        s_indexReady = false;
        for (int i = 1; i <= MAX_DISCS; i++) {
            trackCount[i]  = 0;
            discDirName[i] = "";
            discLabel[i]   = "";
            for (int t = 0; t < MAX_TRACKS_STORED; t++) {
                trackFiles[i][t] = "";
            }
        }
        if (!usbDriveIsConnected()) {
            Diagnostics::setError(Diagnostics::SystemError::NoUsb);
        } else {
            Diagnostics::setError(Diagnostics::SystemError::UsbFsErr);
        }
    }
    wasUsbMounted = isMounted;

    // Pelny zapis indeksu (dziesiatki KB, setki ms operacji flash) tylko przy
    // zgaszonym radiu — w trakcie sesji zatrzymywalby zadanie magistrali.
    if (s_indexSavePending && isMounted && !UnilinkProtocol::busActive()) {
        s_indexSavePending = false;
        saveIndexToFile();
    }

    // Okresowe sprawdzanie stanu USB/plików (jeśli brak błędów sprzętowych DAC)
    Diagnostics::SystemError currErr = Diagnostics::getError();
    if (currErr != Diagnostics::SystemError::DacPinShort &&
        currErr != Diagnostics::SystemError::DacInitErr &&
        currErr != Diagnostics::SystemError::AudioTaskErr) {
        if (!usbDriveHostIsRunning()) {
            Diagnostics::setError(Diagnostics::SystemError::UsbHostErr);
        } else if (!isMounted) {
            if (millis() < USB_ERROR_GRACE_MS) {
                // czekamy
            } else if (usbDriveIsConnected()) {
                Diagnostics::setError(Diagnostics::SystemError::UsbFsErr);
            } else {
                Diagnostics::setError(Diagnostics::SystemError::NoUsb);
            }
        } else if (s_indexReady && audioGetTotalTrackCount() == 0) {
            Diagnostics::setError(Diagnostics::SystemError::NoTracks);
        }
    }
    
    // --- Wykryj koniec piosenki (zabezpieczenie) ---
    static unsigned long notRunningSince = 0;
    if (isPlaying && !trackChanging && !playRequestPending) {
        if (audio.isRunning()) {
            songStarted = true;
            notRunningSince = 0;
        } else {
            if (notRunningSince == 0) {
                notRunningSince = millis();
            } else if (millis() - notRunningSince > (songStarted ? 300UL : 800UL)) {
                Serial.println("[Audio] Wykryto koniec odtwarzania (isRunning()==false, debounce)");
                audioSetMute(true);
                isPlaying = false;
                songStarted = false;
                songFinishedFlag = true;
                notRunningSince = 0;
            }
        }
    } else {
        notRunningSince = 0;
    }
}

void audioRescan() {
    if (usbDriveIsMounted()) {
        Serial.println("[Audio] Ponowne skanowanie pendrive'a...");
        scanDiscs();
    }
}

void audioSetVolume(uint8_t vol) {
    if (vol > 21) vol = 21;
    volRequestValue = vol;
    volRequestPending = true;
    Serial.printf("[Audio] Głośność: %d/21 (zlecone)\n", vol);
}

// ============================================================
// Callbacki biblioteki ESP32-audioI2S
// ============================================================

void audio_info(const char *info) {
    if (!info) return;
    if (infoSquelch) return;
    if (strstr(info, "decode error") ||
        strstr(info, "INVALID_") ||
        strstr(info, "syncword") ||
        strstr(info, "stream ready") ||
        strstr(info, "buffers freed") ||
        strstr(info, "Reading file") ||
        strstr(info, "Content-Length") ||
        strstr(info, "ID3 ") ||
        strstr(info, "Audio-Length") ||
        strstr(info, "Channels:") ||
        strstr(info, "SampleRate") ||
        strstr(info, "BitsPerSample") ||
        strstr(info, "BitRate") ||
        strstr(info, "PSRAM") ||
        strstr(info, "MP3Decoder") ||
        strstr(info, "inputBufferSize") ||
        strstr(info, "free Heap")) {
        return;
    }
    Serial.printf("[Audio-info] %s\n", info);
}

void audio_id3data(const char *info) {
    (void)info;
}

void audio_eof_mp3(const char *info) {
    Serial.printf("[Audio-eof] Koniec utworu: %s\n", info);
    songFinishedFlag = true;
    isPlaying = false;
    songStarted = false;
}

void audio_showstation(const char *info) {
    Serial.printf("[Audio-station] %s\n", info);
}

void audio_showstreamtitle(const char *info) {
    Serial.printf("[Audio-title] %s\n", info);
}

void audio_bitrate(const char *info) {
    Serial.printf("[Audio-bitrate] %s\n", info);
}

void audio_commercial(const char *info) {
    Serial.printf("[Audio-commercial] %s\n", info);
}

void audio_icyurl(const char *info) {
    Serial.printf("[Audio-icyurl] %s\n", info);
}

void audio_lasthost(const char *info) {
    Serial.printf("[Audio-lasthost] %s\n", info);
}

void audio_eof_speech(const char *info) {
    Serial.printf("[Audio-eof-speech] %s\n", info);
}
