maykello/Emulacja-Sony-Unilink/ESP32/Emulator/src/AudioPlayer.h

#ifndef AUDIO_PLAYER_H
#define AUDIO_PLAYER_H

#include <Arduino.h>

// --- KONFIGURACJA PINÓW I2S (PCM5102A DAC) ---
// PCM5102A SCK → podłączyć do GND (moduł sam generuje zegar z BCK/LRCK)
#define I2S_BCK_PIN    7   // Bit Clock
#define I2S_LRCK_PIN  15   // Word Select (Left/Right Clock)
#define I2S_DIN_PIN   13   // Data In
#define I2S_XSMT_PIN  16   // Soft Mute PCM5102A (LOW = Wyciszony, HIGH = Odciszony)
// GPIO 12 — wolny (zapasowy kabel)

// --- NOŚNIK: USB PENDRIVE ---
// Pendrive podłączany do portu USB-OTG (GPIO 19/20, obsługiwane przez UsbDrive.h)
// Nie potrzebne dodatkowe piny — USB OTG jest wbudowane w ESP32-S3

// --- STAŁE ---
#define MAX_DISCS       14
#define MAX_TRACKS      99
#define AUDIO_VOLUME    18   // 0..21 (biblioteka ESP32-audioI2S)

// --- INTERFEJS MODUŁU AUDIO ---

// Inicjalizacja USB Host i I2S. Skanuje foldery CD01..CD10 na pendrivie.
// Zwraca true jeśli inicjalizacja powiodła się.
bool audioInit();

// Rozpocznij odtwarzanie tracka (disc: 1..10, track: 1..99).
// Jeśli plik nie istnieje — próbuje .mp3, potem .wav, .flac, .aac.
// Opcjonalny startSec pozwala wznowić od określonej sekundy utworu.
// Zwraca true jeśli plik znaleziony i odtwarzanie rozpoczęte.
bool audioPlayTrack(uint8_t disc, uint8_t track, uint32_t startSec = 0);

// Zatrzymaj odtwarzanie.
void audioStop();

// Czy aktualnie odtwarza muzykę?
bool audioIsPlaying();

// Pobierz aktualny czas odtwarzania (sekundy od początku utworu).
uint32_t audioGetCurrentTimeSec();

// Pobierz całkowity czas trwania utworu (sekundy). 0 jeśli nieznany.
uint32_t audioGetDurationSec();

// Przewijanie wzgledne w obrebie biezacego utworu (+/- sekundy). Ogranicza do
// [0, czas_trwania). Zwraca true jesli skok sie powiodl.
bool audioSeekRelative(int deltaSec);

// Ustaw absolutna pozycje odtwarzania (sekundy od poczatku utworu).
// Wewnetrznie liczy delte wzgledem audioGetCurrentTimeSec() i zleca seek
// asynchronicznie. Zwraca true jesli zlecono skok.
bool audioSeekToSec(uint32_t targetSec);

// Wycisz lawine audio_info (decode error / syncword) — wlaczac na czas
// skanowania FF/REW, gdy setTimeOffset generuje setki komunikatow/s.
void audioSetInfoSquelch(bool squelch);

uint8_t audioGetTrackCount(uint8_t disc);
uint16_t audioGetTotalTrackCount();
bool audioIndexReady();

// --- INTERFEJS NAZW (źródło dla CD-TEXT) ---
// Zwraca nazwę utworu (źródło: nazwa pliku) dla danego dysku/utworu.
// disc: 1..10, track: 1..99 (1-based, jak na radiu).
// Nazwa kopiowana do `out` (zawsze zakończona NUL-em, ograniczona do maxLen).
// Zwraca liczbę zapisanych znaków (bez terminatora).
// Dysk/utwór poza zakresem, brak nośnika lub pusty bufor -> out="" i zwraca 0.
// UWAGA: zwraca SUROWĄ nazwę (po odcięciu rozszerzenia pliku). Sanityzacja do
// drukowalnego ASCII odbywa się później w module CdText (nie tutaj).
size_t audioGetTrackName(uint8_t disc, uint8_t track, char* out, size_t maxLen);

// Zwraca nazwę płyty (źródło: nazwa katalogu, np. "CD01") dla danego dysku.
// disc: 1..10. Pozostałe zasady jak w audioGetTrackName.
size_t audioGetDiscName(uint8_t disc, char* out, size_t maxLen);

// Znajdź następny niepusty dysk (startując od disc+1, zawijając do 1..10).
// Zwraca 0 jeśli ŻADEN dysk nie ma tracków.
uint8_t audioFindNextNonEmptyDisc(uint8_t disc);

// Znajdź poprzedni niepusty dysk.
uint8_t audioFindPrevNonEmptyDisc(uint8_t disc);

// Czy piosenka właśnie się skończyła? (jednorazowa flaga, resetuje się po odczycie)
bool audioSongFinished();

// MUSI być wywoływane w każdej iteracji loop()!
// Obsługuje dekodowanie audio, przesyłanie I2S, i hot-plug pendrive'a.
void audioLoop();

// Ponowne skanowanie folderów (np. po podpięciu pendrive'a).
void audioRescan();

// Ustaw głośność (0..21).
void audioSetVolume(uint8_t vol);

// Sterowanie wyciszeniem sprzętowym DAC (XSMT na PCM5102A, GPIO 16).
// true = wycisz (LOW), false = odcisz (HIGH).
void audioSetMute(bool mute);
void audioSetSeekMute(bool mute);
void audioRefreshIndexFreeClusters();
bool audioIsBusyChangingTrack();

#endif // AUDIO_PLAYER_H
