maykello/Emulacja-Sony-Unilink/(commit log)

2026-06-05 ESP32 sniffer v2, ring buffer & logger UI
2026-06-07 Use songStarted flag to detect track EOF
2026-07-05 Restructure ESP32 project for PlatformIO layout
2026-09-03 cd-text działa
    cd-text działa z opóźnieniem, trzeba przeanalizować czy jest w literaturze internet coś o display w sony unilink (przycisk na radio).
    nie działa cd name dalej. On się probuje pokazac w display jako disc wtedy jest pusto potem pokazuje track i jest nasz track ktory dziala. dodatkowo na list nie widac nazw cd. Trzeba przeszukac internet oraz sprawdzić jak działa sonyunilink
2026-09-04 support up to 14 CDs and fix cd-text in tracks <15,99>
    [AudioPlayer.h, Config.h, Magazine.h, UnilinkProtocol.cpp]
2026-09-05 mosfet mod
2026-09-10 czas liczy 1hz ale cd text tylko jak user zmieni display
2026-09-11 16 min bez crash
    [CdChanger.cpp, CdText.cpp, Config.h, UnilinkProtocol.cpp]
2026-09-11 40 min bez crash
    [Config.h, UnilinkProtocol.cpp]
2026-09-11 godzina grania w komentarzu problemy
    - czas chodzi jak chce ale jest w miarę
    - zdarzyło się że zamiast zcasu wyswietlało --.-- naprawilem to krotkim przewinieciem
    - track name pokazuje sie z opoznieniem przez co prez 4 sekundy nawet po przepiediu utworu radio pokazuje brak tyyulu w track name
    - scrashowąło tam z 3 razy ale zawsze był dobry recover
    [Config.h, Diagnostics.cpp, Diagnostics.h, Emulator.cpp, UnilinkProtocol.cpp, WiFiLogger.cpp, WiFiLogger.h]
2026-09-15 moze jest lepiej
    - czas żyje wlasnym zyciem, ie jest idelanie 1hz
    - czy da sie jeszcze przspieszyc?
    - byly 2 crashe ale był recover ale lepiej jakby nie było crashy w ogole
    [Config.h, UnilinkProtocol.cpp]
2026-10-30 Handle track navigation across discs
    Advance to the next non-empty disc at the end of a CD and move to the previous disc's final track when navigating backward from the beginning. Notify the protocol layer about disc changes from manual and automatic track transitions.
2026-11-01 Improve UniLink recovery and diagnostics
    Refine slave-break timing, clock spike filtering, and handling of truncated frames. Preserve blackbox and diagnostic data across crash resets, while improving address validation, radio power-state handling, and playback behavior.
